sqf-ice/39_CUITBIKE/成信车队.bmp

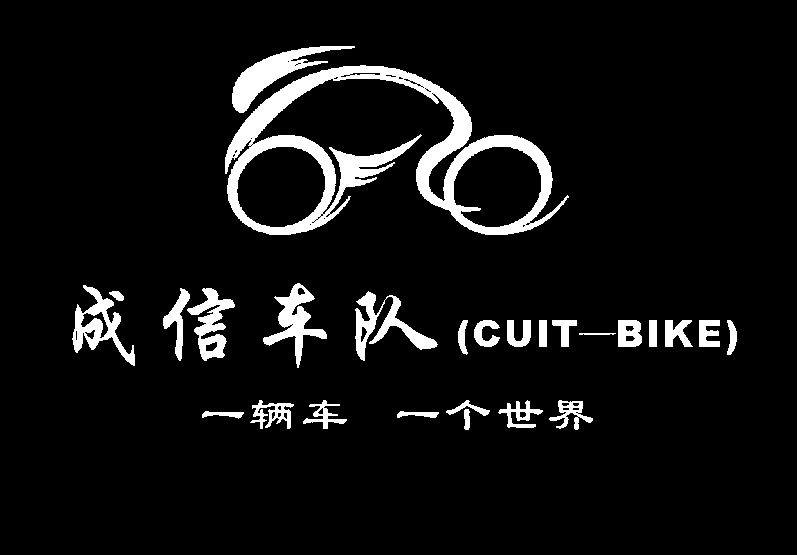
成信车队.bmp
