sqf-ice/39_CUITBIKE/v1.2/SCH/cuitbike_v1_2.pdf

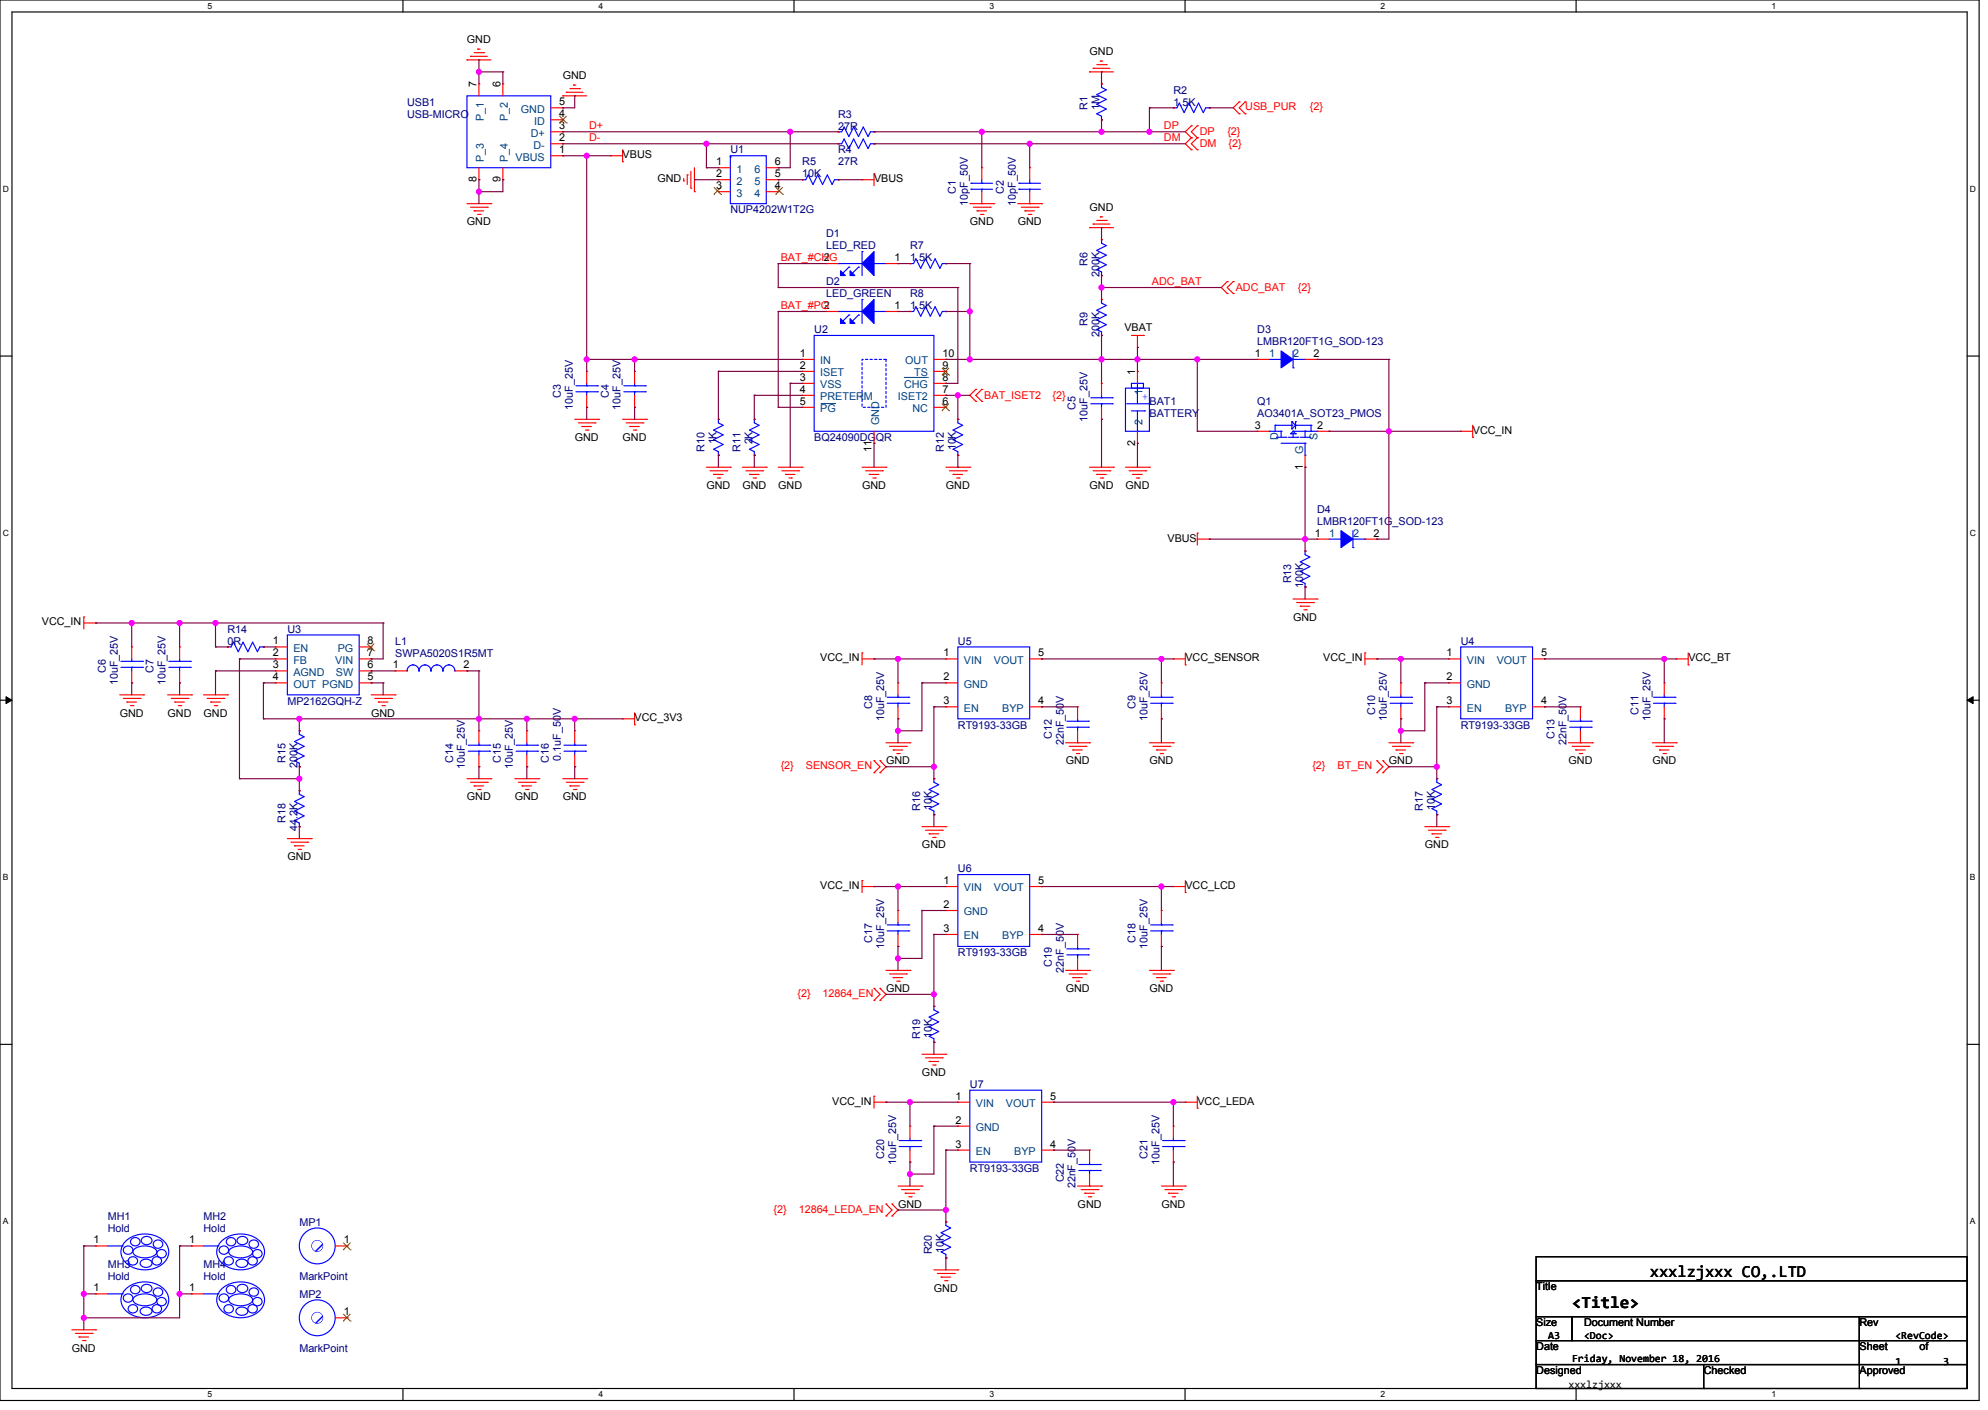
[picture p2: page 1]

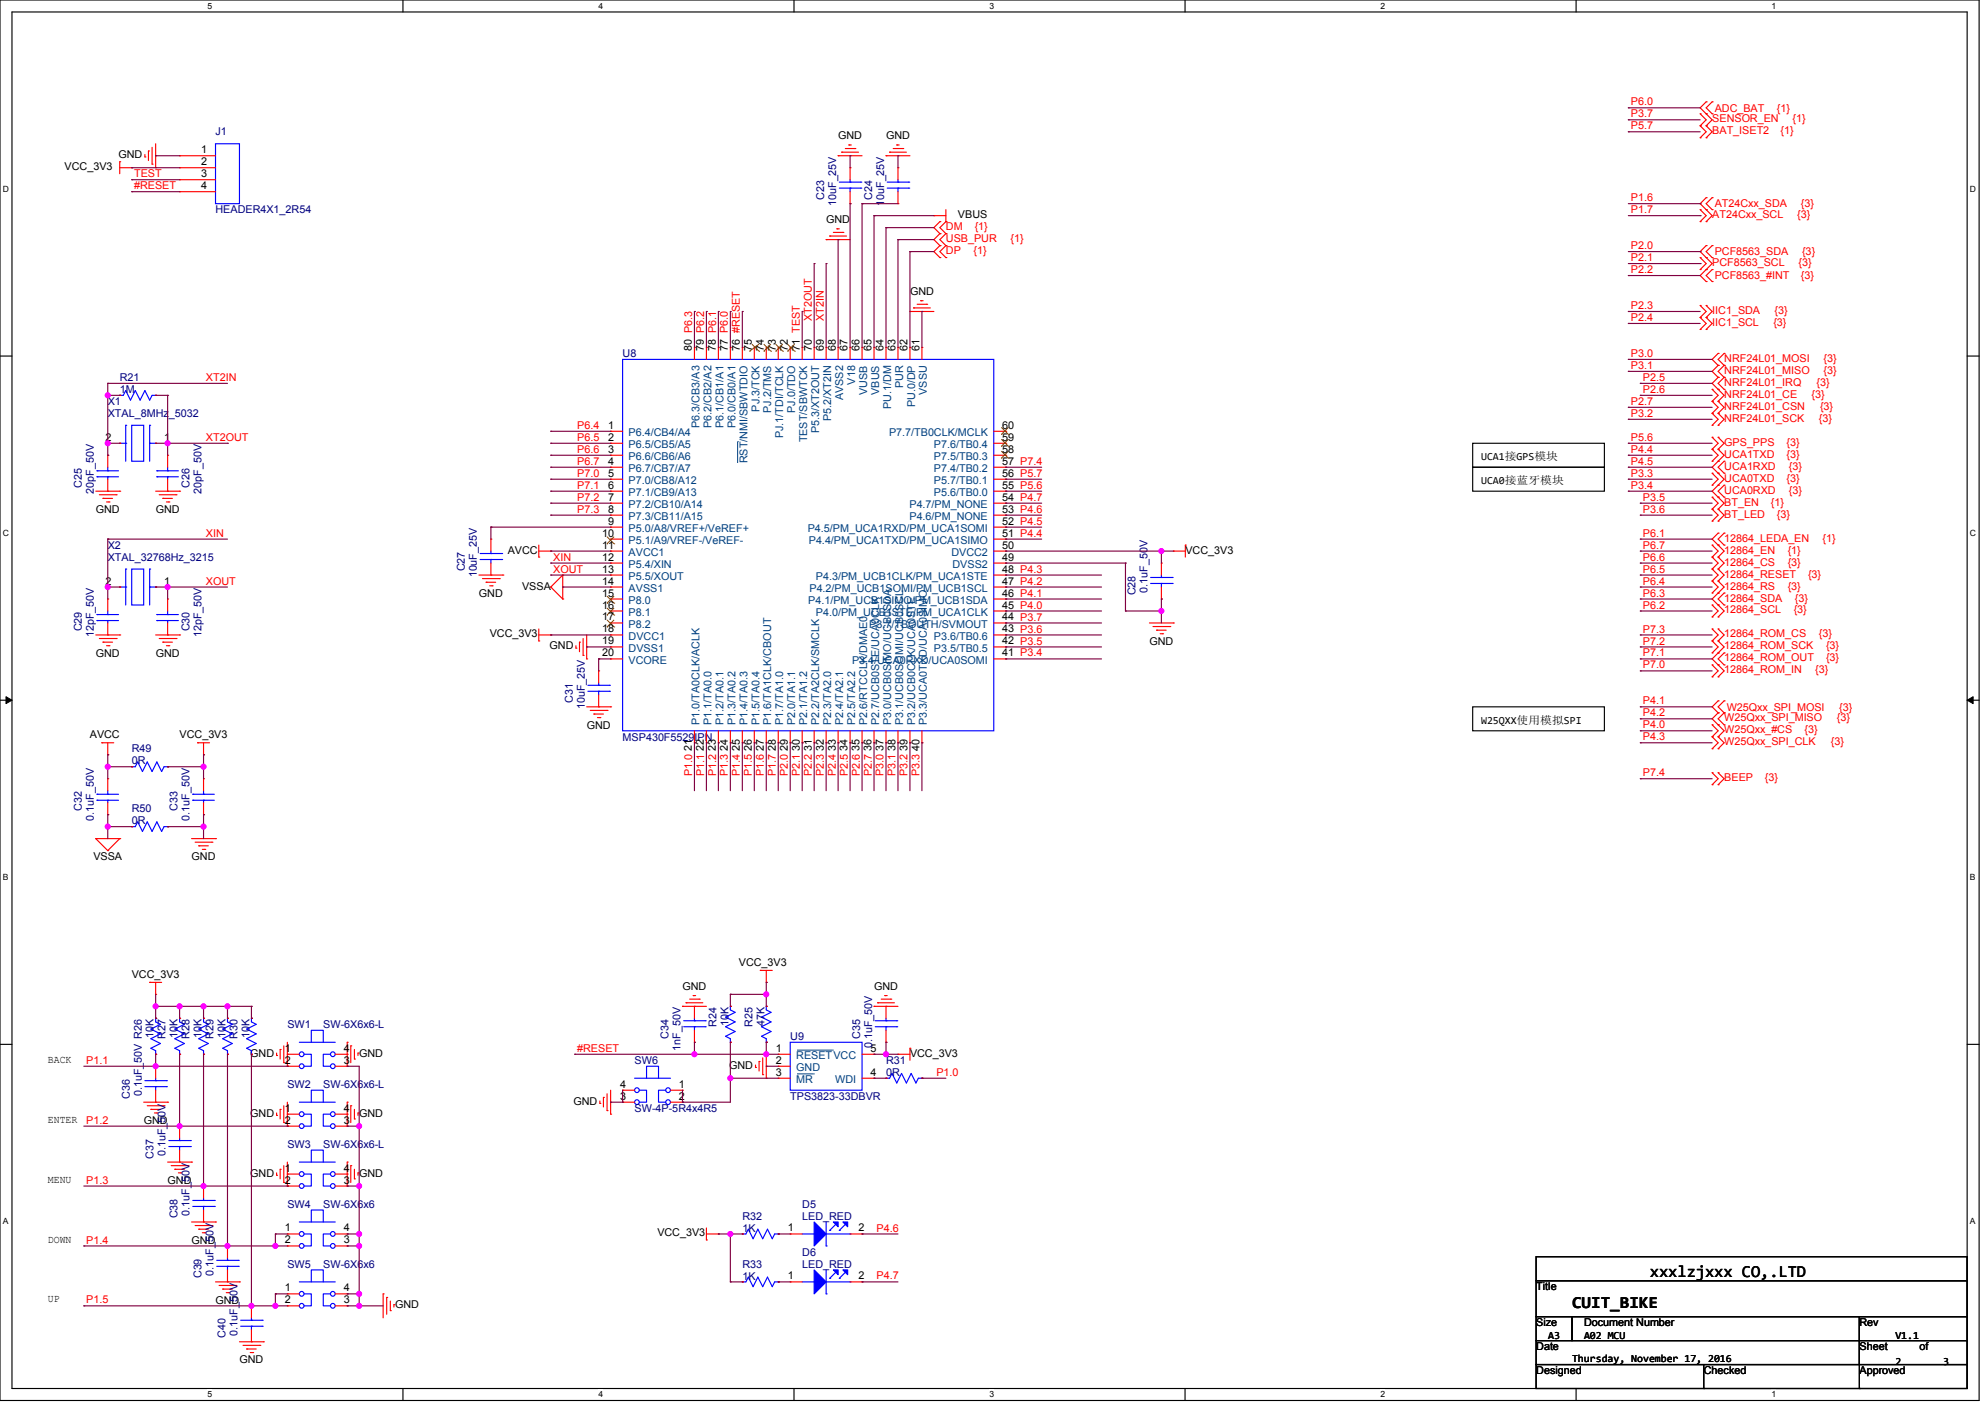
[picture p3: page 2]

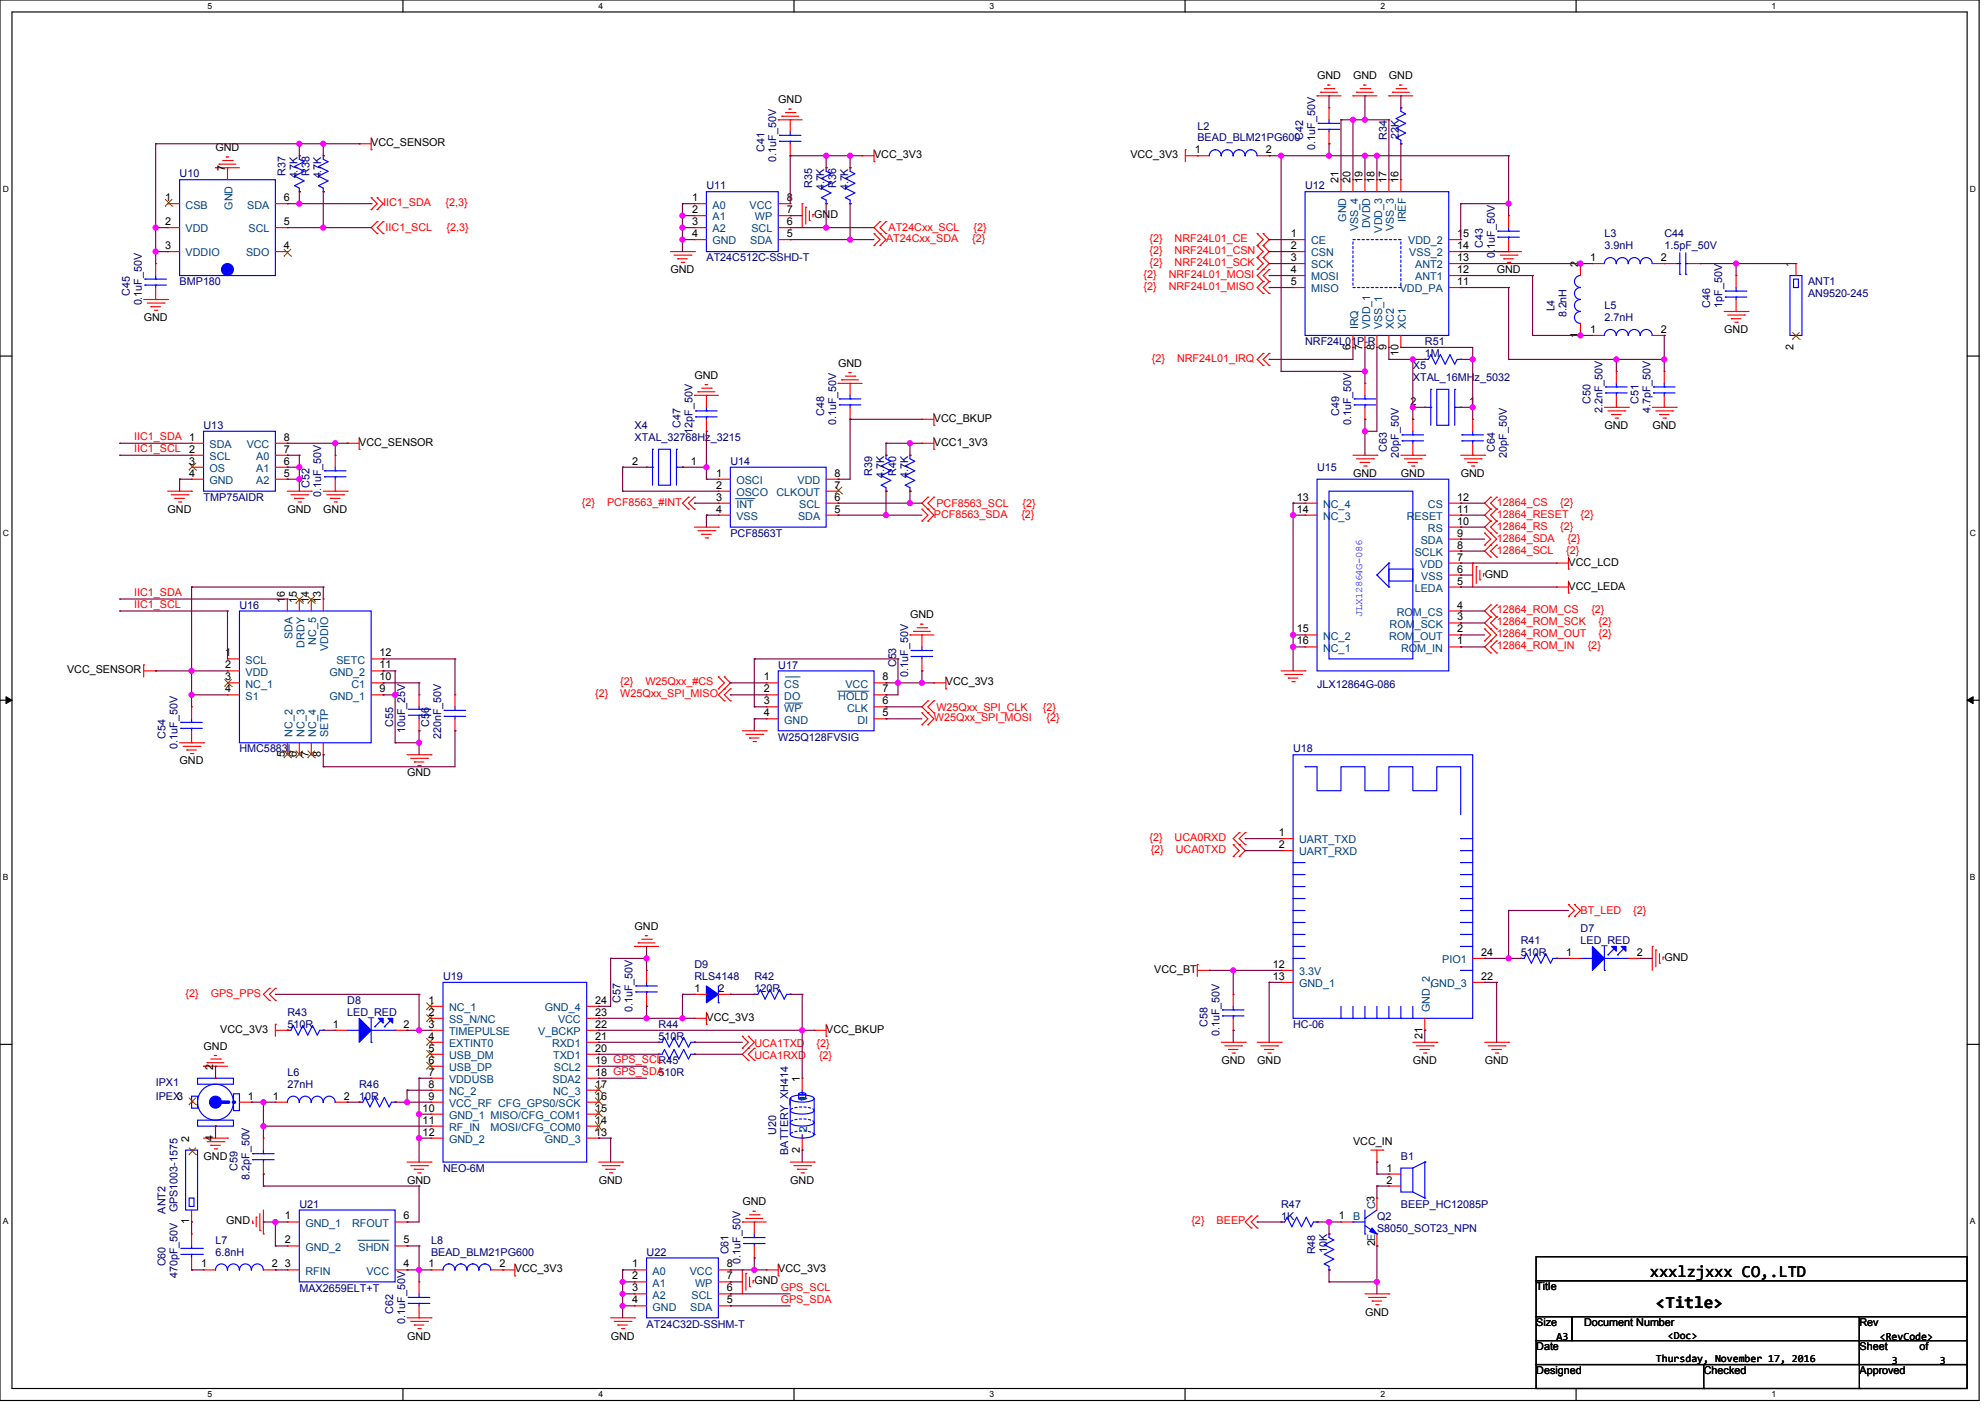
[picture p4: page 3]

SETP 8 GND_1 9 C1 10 GND_2 11 SETC 12 VDDIO 13 NC_5 14 DRDY 15 SDA 16
