sqf-ice/39_CUITBIKE/v1.1/cuitbike_v1_1_stm32.pdf

D | D

## MODE：模式选择。1：burst模式，高效率高纹波。0：pwm模式。

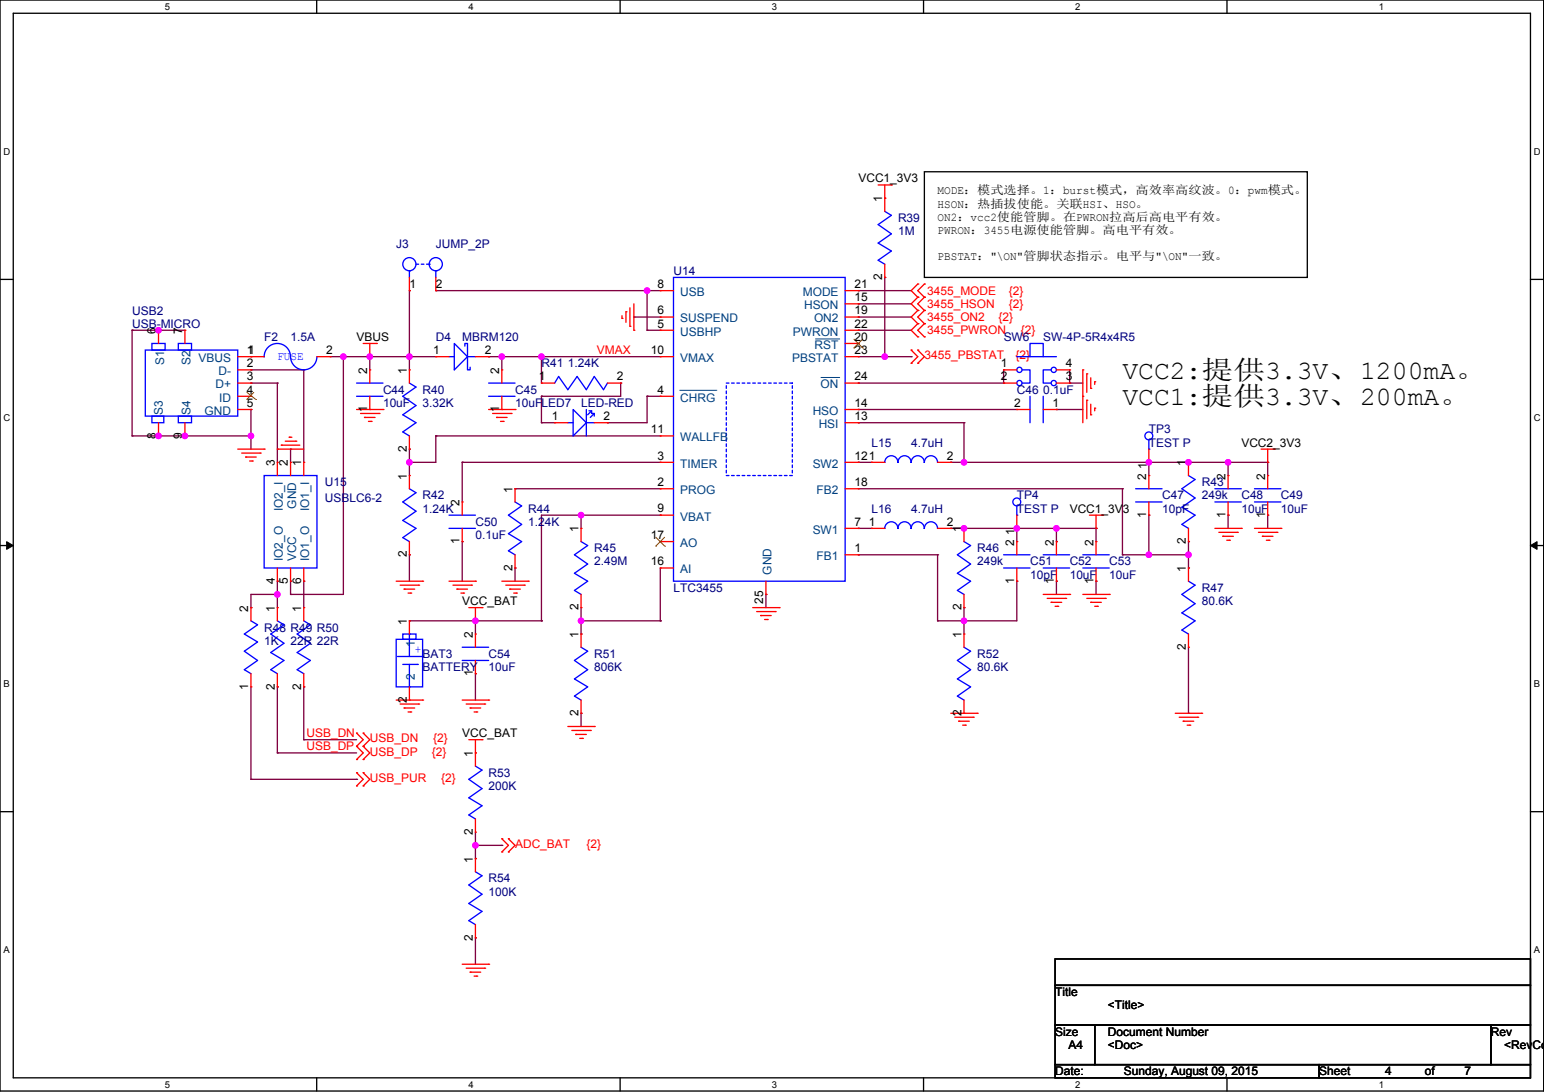
[picture p15: page 1]

HSON：热插拔使能。关联HSI、HSO。
ON2：vcc2使能管脚。在PWRON拉高后高电平有效。
PWRON：3455电源使能管脚。高电平有效。

PBSTAT："\ON"管脚状态指示。电平与"\ON"一致。

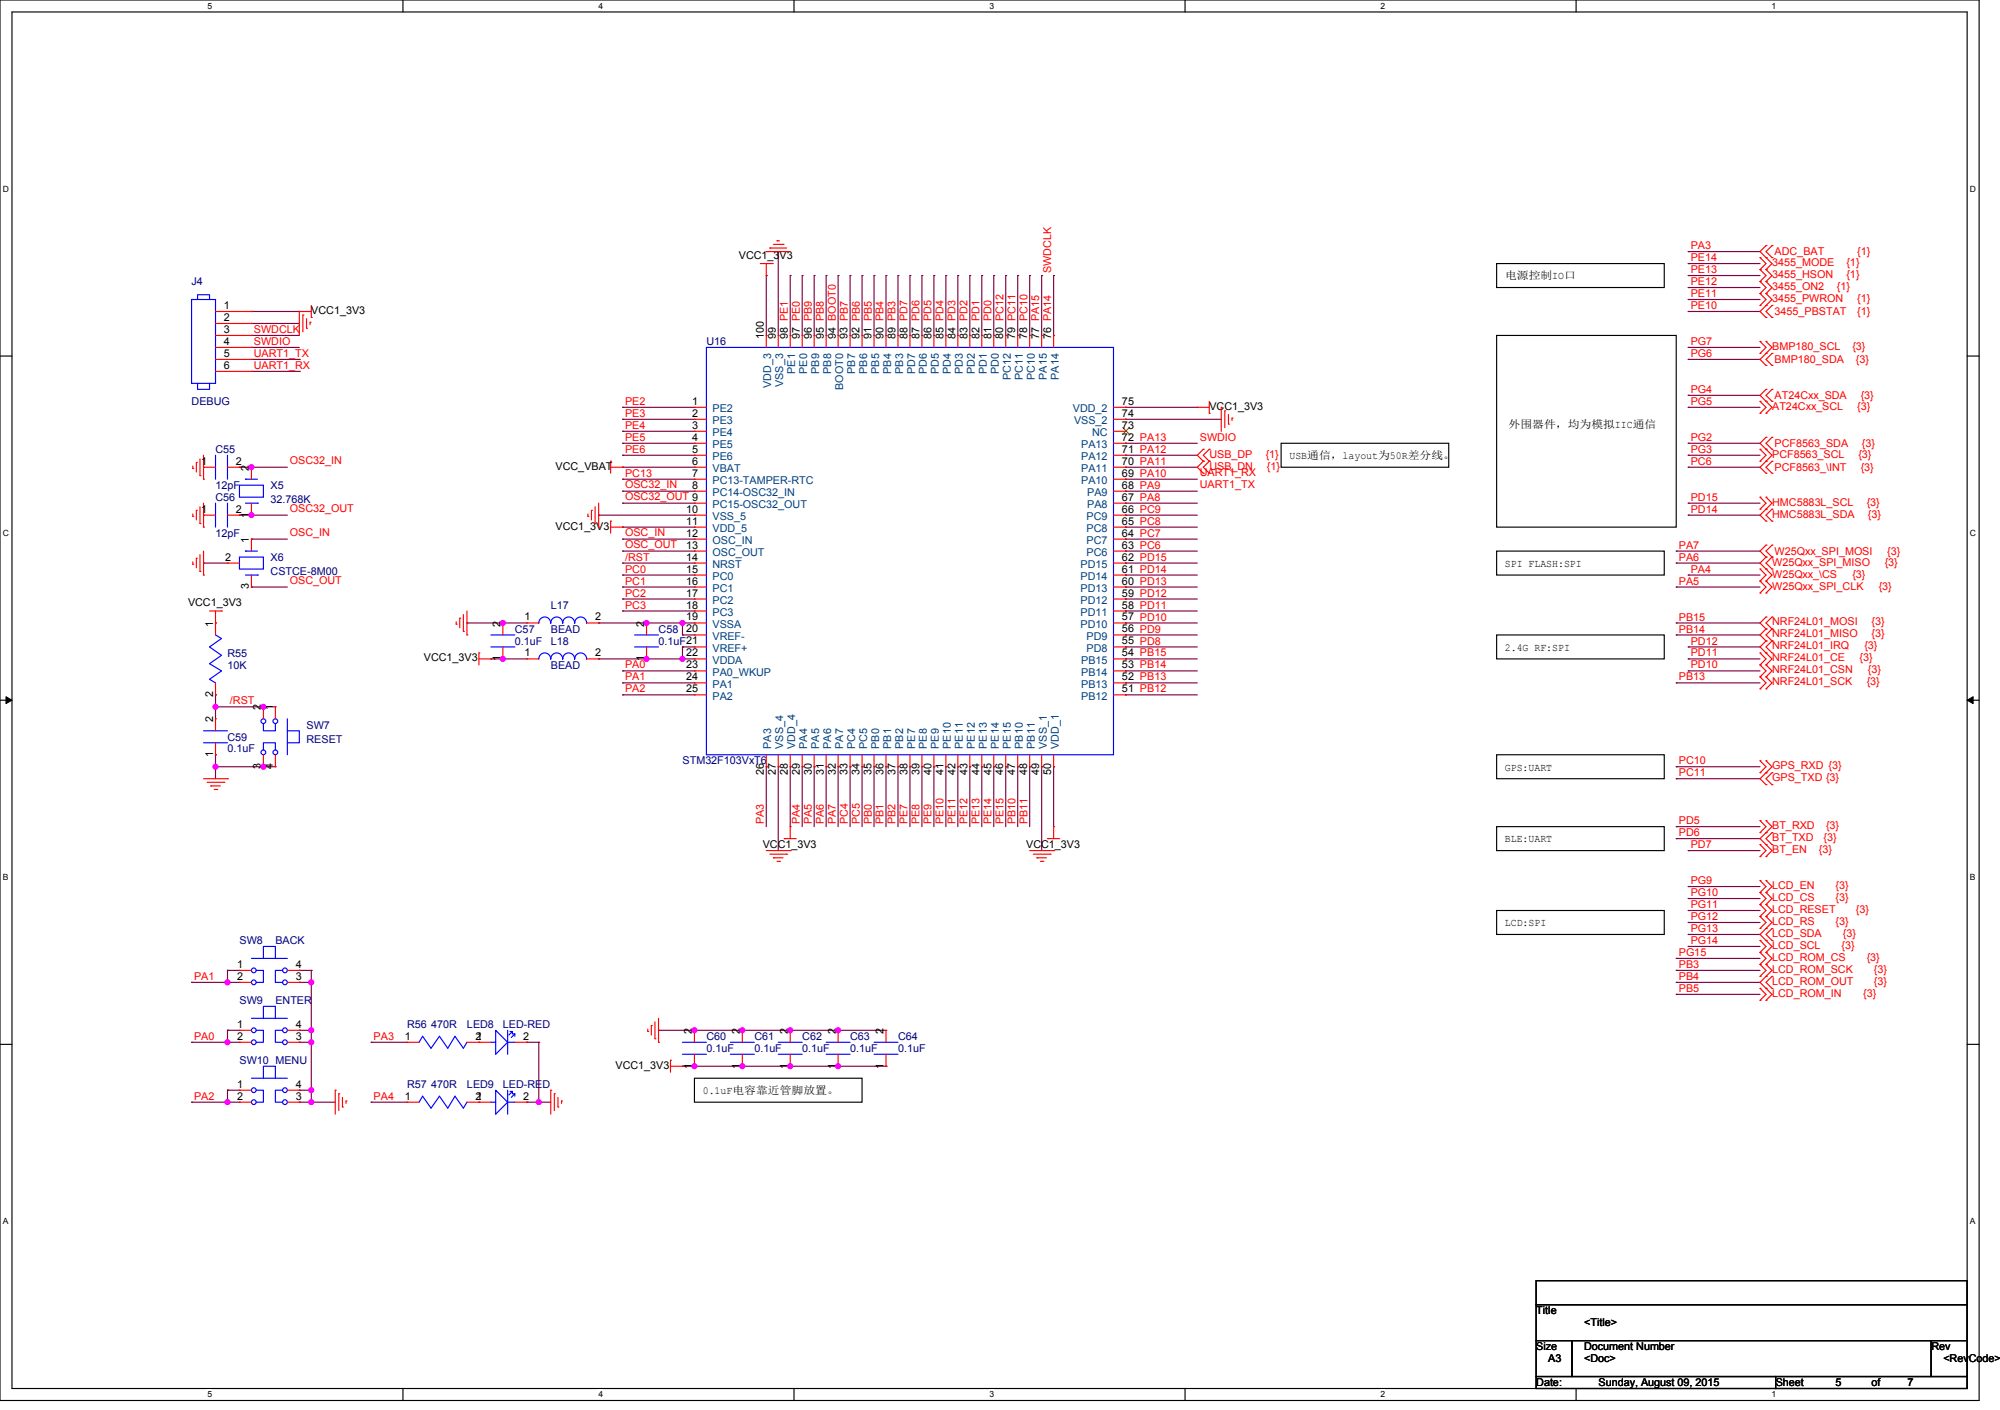
[picture p16: page 2]

气压传感器 | EEPROM | RTC

2.4G

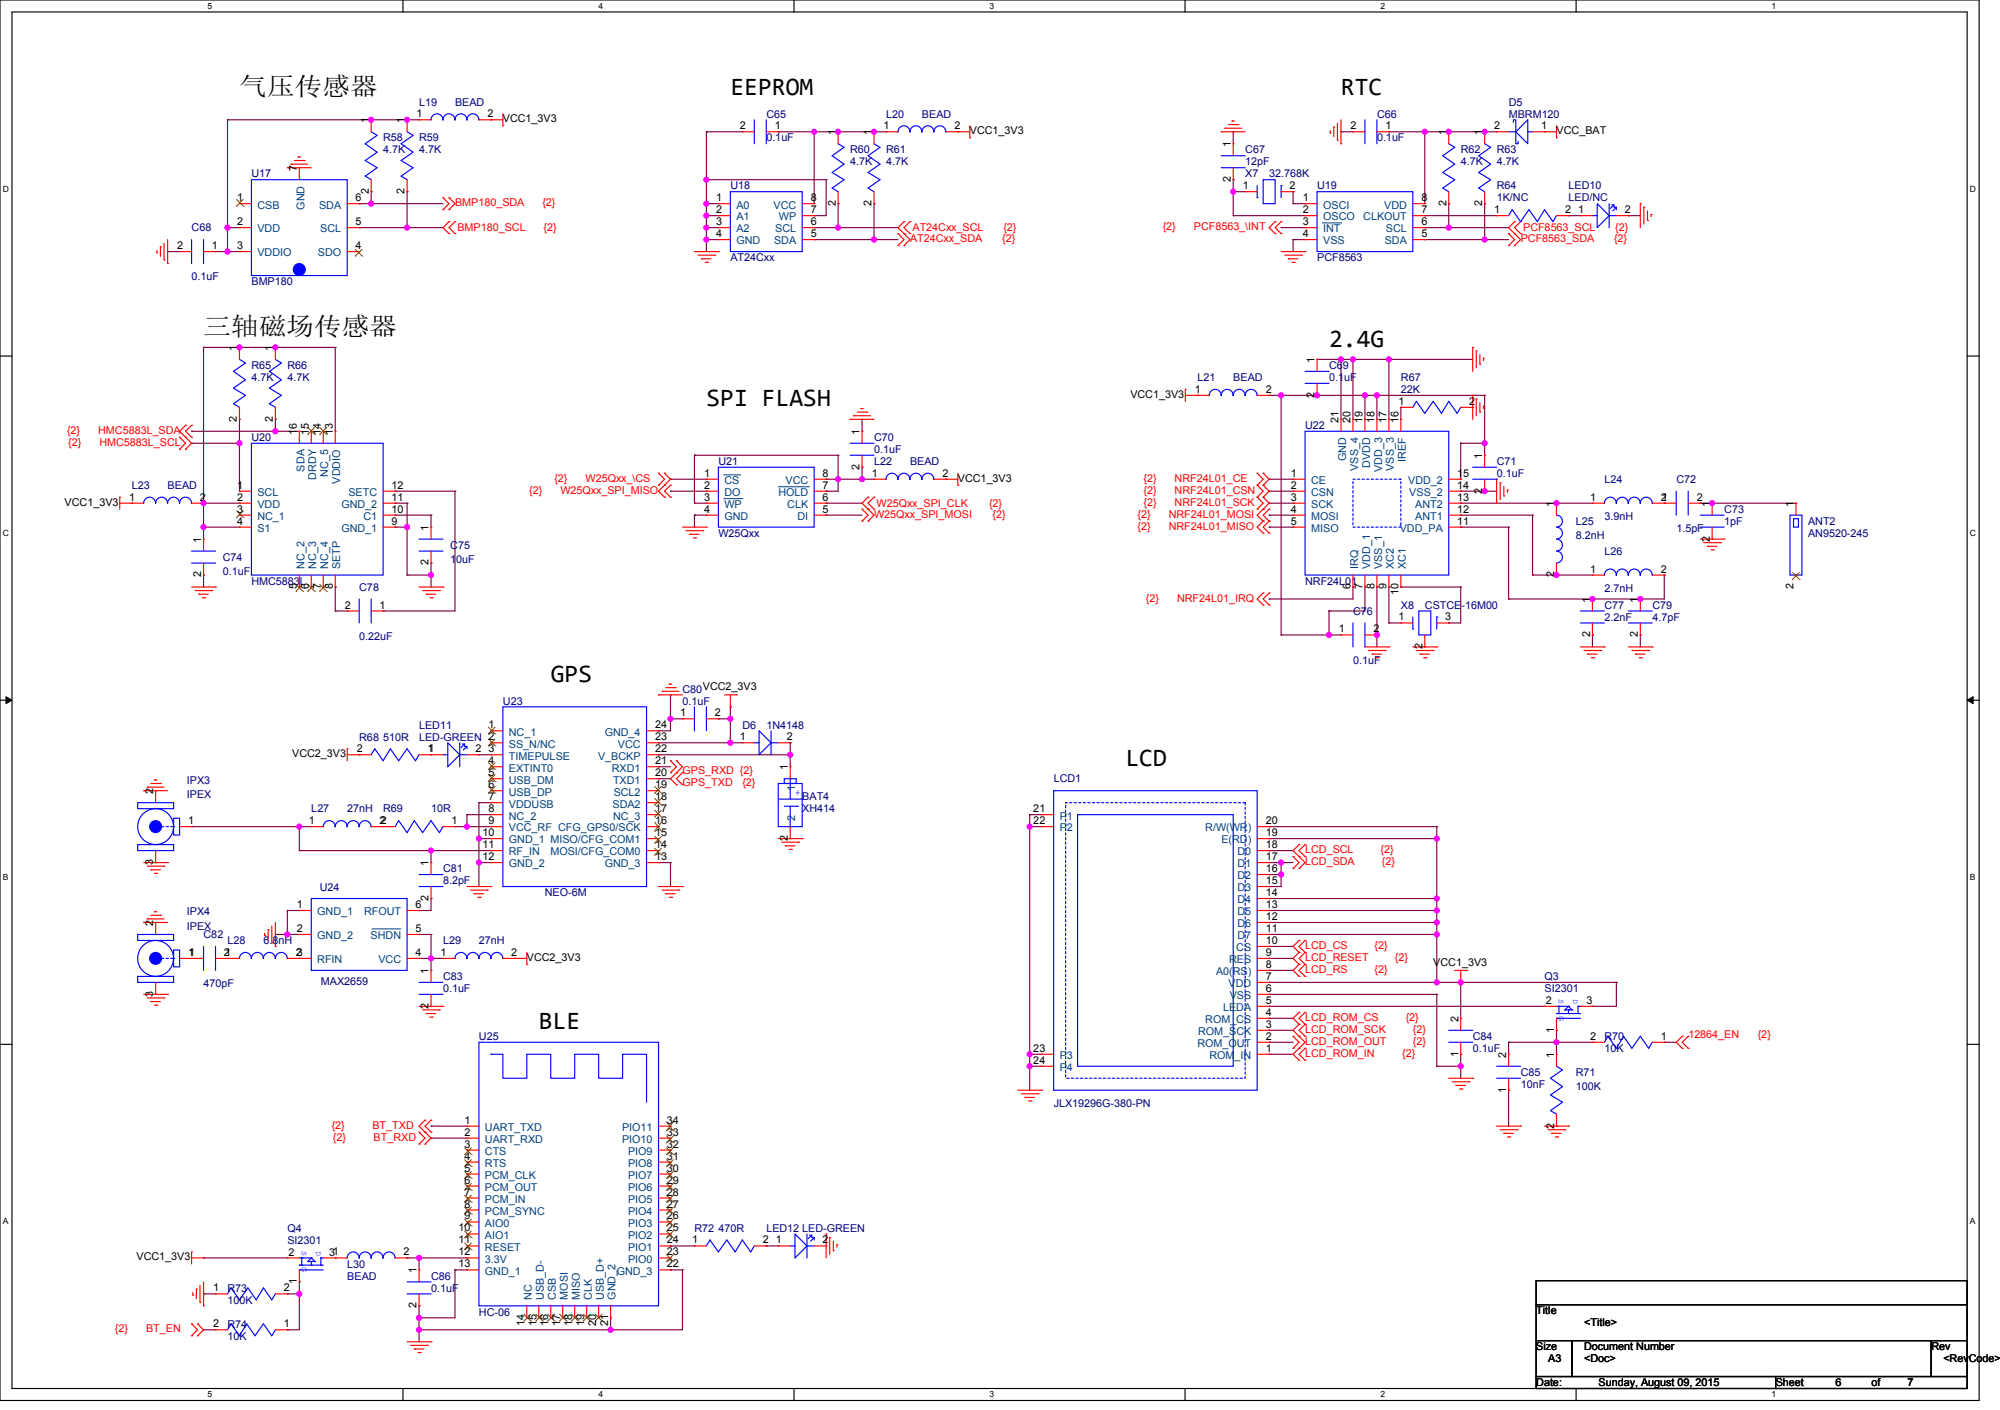
[picture p17: page 3]

SETP 8 GND_1 9 C1 10 GND_2 11 SETC 12 VDDIO 13 NC_5 14 DRDY 15 SDA 16
