sqf-ice/39_CUITBIKE/v1.1/cuitbike_v1_1_RF.pdf

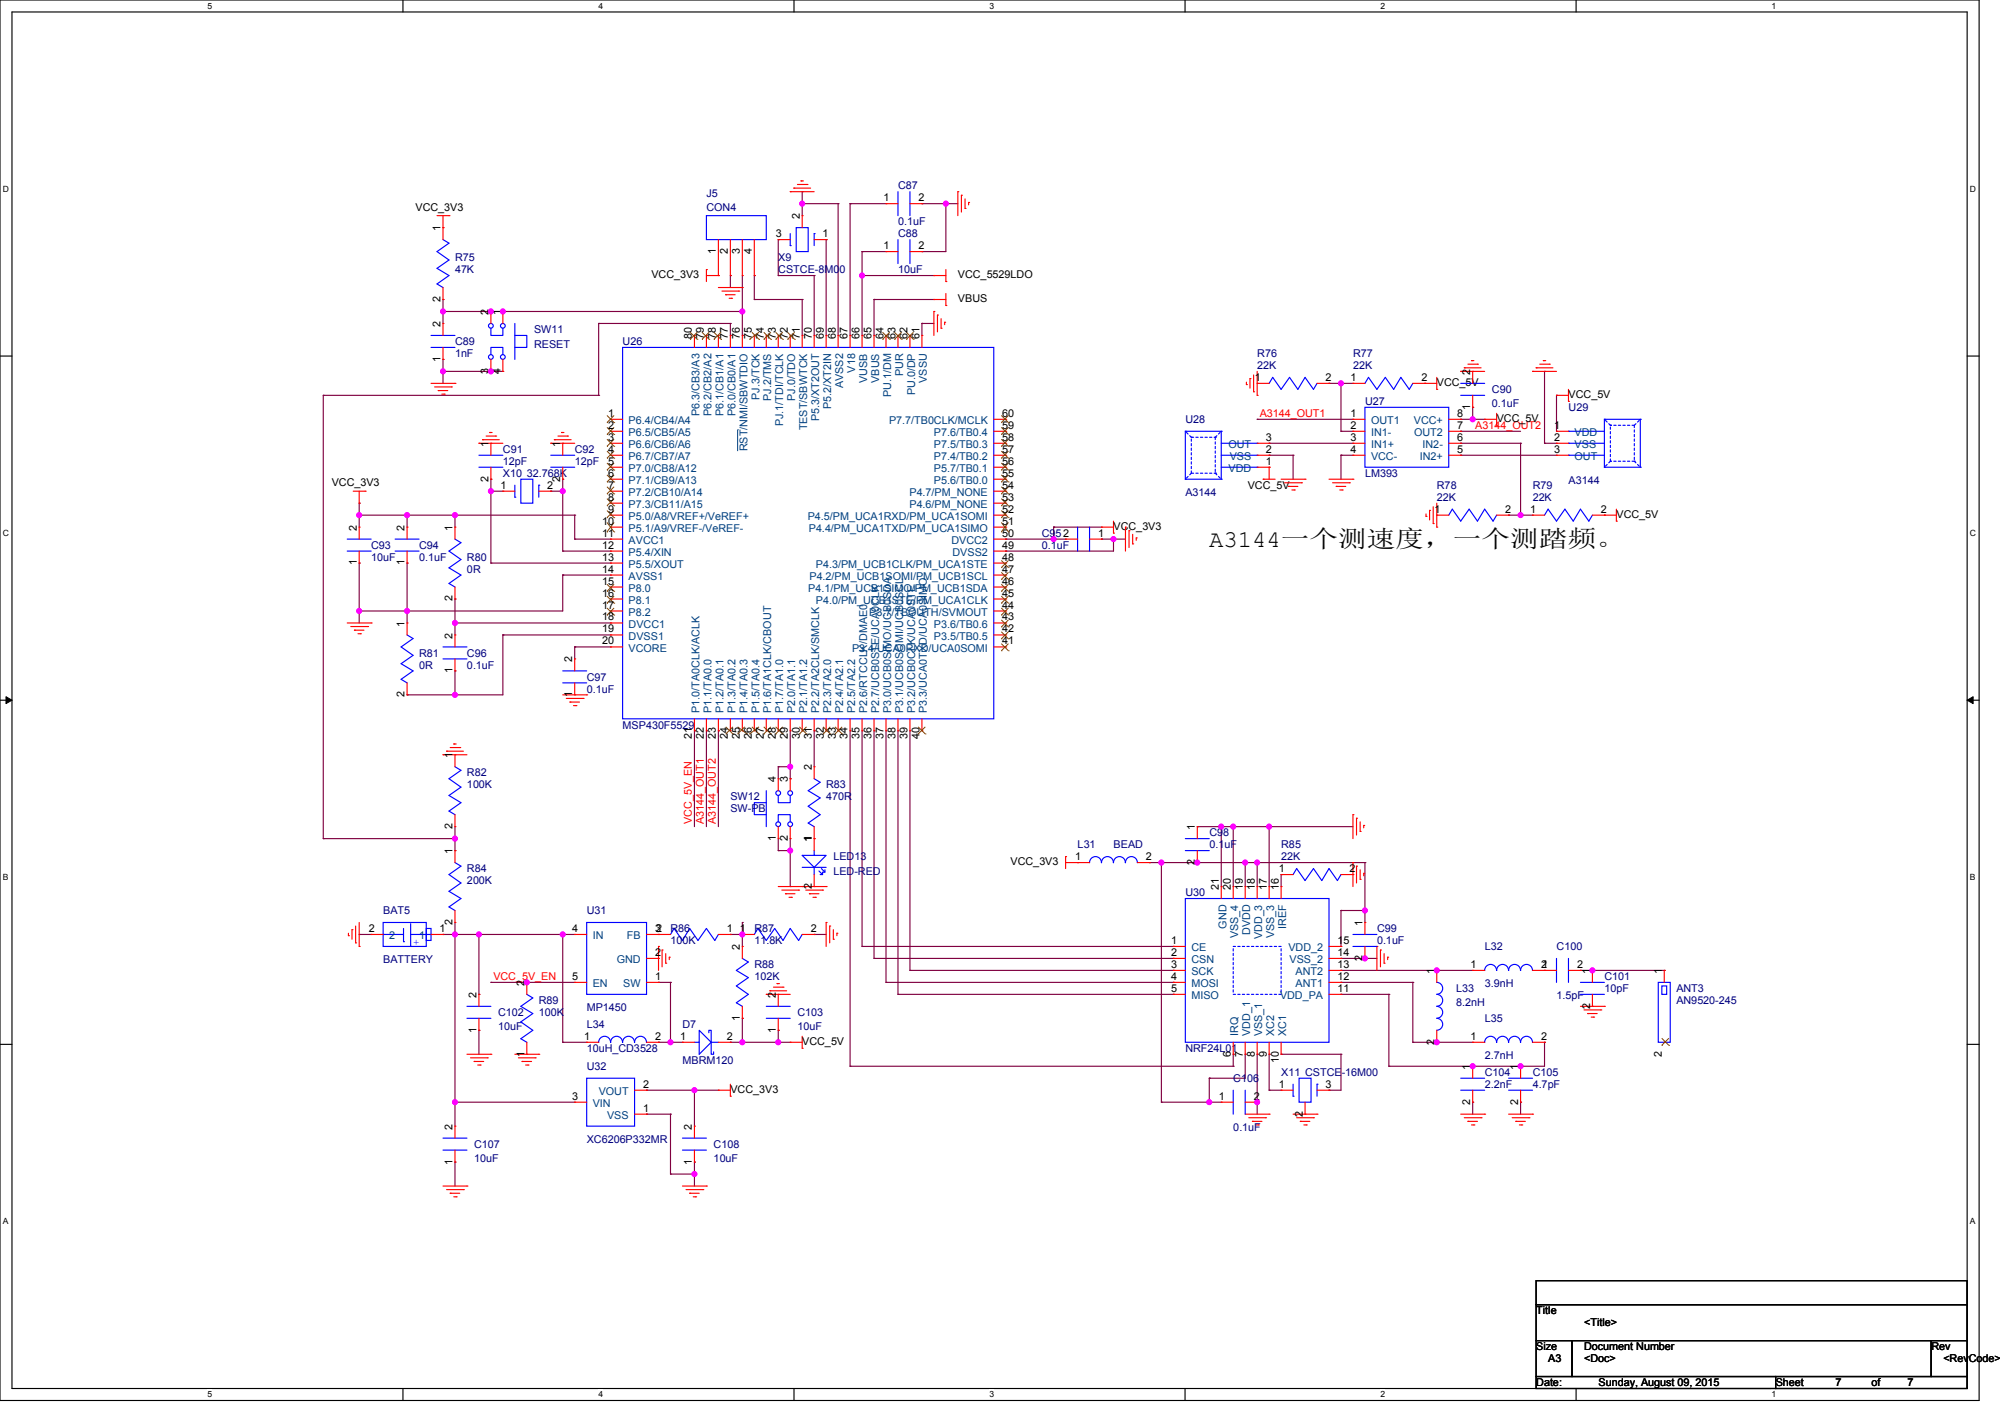
[picture p18: page 1]
