sqf-ice/39_CUITBIKE/(list of files, drawings)

Other design files:
v1.0/Imported MSP430FR5969v1.0.PrjPcb/FR5969v1.0.PcbLib
v1.0/Imported MSP430FR5969v1.0.PrjPcb/FR5969v1.0.PrjPcb
v1.0/Imported MSP430FR5969v1.0.PrjPcb/FR5969v1.0.SchDoc
v1.0/Imported MSP430FR5969v1.0.PrjPcb/FR5969v1.0.SchLib
v1.0/Imported MSP430FR5969v1.0.PrjPcb/LCD.SchDoc
v1.0/Imported MSP430FR5969v1.0.PrjPcb/Modular.SchDoc
v1.0/Imported MSP430FR5969v1.0.PrjPcb/MSP430FRxxxx.SchDoc
v1.0/Imported MSP430FR5969v1.0.PrjPcb/POWER.SchDoc
v1.1/SCH/CUITBIKE_V1_1.DSN
v1.1/SCH/CUITBIKE_V1_1.opj
v1.2/SCH/CUITBIKE_V1_2.DSN
v1.2/SCH/CUITBIKE_V1_2.opj
