sqf-ice/39_CUITBIKE/CUITBIKE_V12_MSP430-SV10_161201_D/HARDWARE/JLX12864/LCD12864.c

/*
 * LCD12864.c
 *
 *  Created on: 2014-11-29
 *      Author: dell
 */


#include "includes.h"

//***********************************************************************
const unsigned char page1[] = {
/*--  调入了一幅图像：C:\Users\xxxlzjxxx\Desktop\页面1 - 副本.bmp  --*/
/*--  宽度x高度=128x64  --*/
0x00,0x00,0x00,0x00,0x00,0x00,0x00,0x00,0x00,0x80,0x80,0x80,0x80,0x00,0x00,0x00,
0x00,0x00,0x80,0x00,0x00,0x00,0x00,0x00,0x00,0x00,0x00,0x00,0x80,0x80,0x80,0x00,
0x00,0x00,0x00,0x00,0x00,0x00,0x00,0x00,0x00,0x00,0x00,0x00,0x00,0x80,0x80,0x80,
0x00,0x00,0x00,0x00,0x00,0x00,0x00,0x00,0x00,0x00,0x00,0x80,0x80,0x00,0x00,0x00,
0x80,0x80,0x80,0x80,0x80,0x80,0x80,0x80,0x00,0x00,0x00,0x00,0x00,0x00,0x00,0x00,
0x00,0x00,0x00,0x00,0x00,0x00,0x00,0x00,0x00,0x00,0x00,0x00,0x00,0x00,0x00,0x00,
0x00,0x00,0x00,0x00,0x00,0x00,0x00,0x00,0x00,0x00,0x00,0x00,0x00,0x00,0x00,0x00,
0x00,0x00,0x00,0x00,0x00,0x00,0x00,0x00,0x00,0x00,0x00,0x00,0x00,0x00,0x00,0x00,
0x00,0x00,0x00,0x00,0x24,0x25,0xE5,0x05,0xFF,0xFF,0x04,0xE4,0x24,0xA4,0x00,0xFE,
0x00,0x00,0xFF,0x00,0x00,0x00,0x98,0x9C,0x9C,0x9E,0x96,0x93,0x91,0xF1,0xF1,0x93,
0x97,0x9E,0x8C,0x8C,0x98,0x00,0x00,0x10,0x18,0x9C,0x8C,0x9E,0x97,0xB3,0xF1,0xF1,
0x93,0x97,0x9E,0x8C,0x9C,0x18,0x08,0x00,0x00,0x33,0x9D,0xED,0xC9,0xF9,0xB9,0x83,
0x01,0xF9,0x09,0x0F,0xEF,0x09,0xF9,0xF9,0x00,0x00,0x00,0x00,0x00,0x00,0x00,0x00,
0x00,0x30,0x30,0x00,0x00,0x00,0x00,0x00,0x00,0x00,0x00,0x00,0x00,0x03,0x61,0x61,
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

void delayms(int n_ms)
{
	int j,k;
	for(j=0;j<n_ms;j++)
	for(k=0;k<110;k++);
}
//短延时
void delayus(int n_us)
{
	int j,k;
	for(j=0;j<n_us;j++)
	for(k=0;k<1;k++);
}


//写指令到LCD 模块
void transfer_command_lcd(int data1)
{
	char i;

	CS_0();
	RS_0();

	for(i=0;i<8;i++)
	{
		SCLK_0();

		//delay_us(10); //加少量延时
		if(data1&0x80) DIN_1();
		else DIN_0();
		SCLK_1();
		//delay_us(10); //加少量延时
		data1=data1<<=1;
	}
	CS_1();
}
//写数据到LCD 模块
void transfer_data_lcd(int data1)
{
	char i;
	CS_0();
	RS_1();
	for(i=0;i<8;i++)
	{
		SCLK_0();
		if(data1&0x80) DIN_1();
		else DIN_0();
		SCLK_1();
		data1 = (data1<<=1);
	}
	CS_1();
}
//LCD 模块初始化
void Initial_lcd(void)
{
	P6DIR |=RST_PIN | SPI_MOSI_PIN| SPI_CLK_PIN|RS_PIN|CS_PIN;
	P7DIR |=Rom_IN |Rom_SCK|Rom_CS ;
	P7DIR&=~Rom_OUT;
	RST_0(); //低电平复位
	delayms(100);
	RST_1(); //复位完毕
	delayms(100);
	transfer_command_lcd(0xe2); //软复位
	delayms(5);
	transfer_command_lcd(0x2c); //升压步聚1
	delayms(50);
	transfer_command_lcd(0x2e); //升压步聚2
	delayms(50);
	transfer_command_lcd(0x2f); //升压步聚3
	delayms(5);
	transfer_command_lcd(0x23); //粗调对比度，可设置范围0x20～0x27
	transfer_command_lcd(0x81); //微调对比度
	transfer_command_lcd(0x28); //微调对比度的值，可设置范围0x00～0x3f
	transfer_command_lcd(0xa2); //1/9 偏压比（bias）
	transfer_command_lcd(0xc8); //行扫描顺序：从上到下
	transfer_command_lcd(0xa0); //列扫描顺序：从左到右
	transfer_command_lcd(0x40); //起始行：第一行开始
	transfer_command_lcd(0xaf); //开显示
}
void lcd_address(uint page,uint column)
{
	column=column-0x01;
	transfer_command_lcd(0xb0+page-1); //设置页地址，每8 行为一页，全屏共64 行，被分成8 页
	transfer_command_lcd(0x10+(column>>4&0x0f)); //设置列地址的高4 位
	transfer_command_lcd(column&0x0f); //设置列地址的低4 位
}
//全屏清屏
void clear_screen()
{
	unsigned char i,j;
	for(i=0;i<9;i++)
	{
		transfer_command_lcd(0xb0+i);
		transfer_command_lcd(0x10);
		transfer_command_lcd(0x00);
		for(j=0;j<132;j++)
		{
			transfer_data_lcd(0x00);
		}
	}
}
//显示128x64 点阵图像
void display_128x64(const uchar *dp)
{
	uint i,j;
	for(j=0;j<8;j++)
	{
		lcd_address(j+1,1);
		for (i=0;i<128;i++)
		{
			transfer_data_lcd(*dp); //写数据到LCD,每写完一个8 位的数据后列地址自动加1
			dp++;
		}
	}
}
//显示16x16 点阵图像、汉字、生僻字或16x16 点阵的其他图标
void display_graphic_16x16(uchar page,uchar column,const uchar *dp)
{
	uint i,j;
	for(j=0;j<2;j++)
	{
		lcd_address(page+j,column);
		for (i=0;i<16;i++)
		{
			transfer_data_lcd(*dp); //写数据到LCD,每写完一个8 位的数据后列地址自动加1
			dp++;
		}
	}
}
//显示8x16 点阵图像、ASCII, 或8x16 点阵的自造字符、其他图标
void display_graphic_8x16(uchar page,uchar column,const uchar *dp)
{
	uint i,j;
	for(j=0;j<2;j++)
	{
		lcd_address(page+j,column);
		for (i=0;i<8;i++)
		{
			transfer_data_lcd(*dp); //写数据到LCD,每写完一个8 位的数据后列地址自动加1
			dp++;
		}
	}
}
//显示5X8 点阵图像、ASCII, 或5x8 点阵的自造字符、其他图标
void display_graphic_5x8(uchar page,uchar column,const uchar *dp)
{
	uint i;
	lcd_address(page,column);
	for (i=0;i<6;i++)
	{
		transfer_data_lcd(*dp);
		dp++;
	}
}
//送指令到晶联讯字库IC
void send_command_to_ROM( uchar datu )
{
	uchar i;
	for(i=0;i<8;i++ )
	{
		Rom_SCK_0();
		delayus(10);
		if(datu&0x80)  Rom_IN_1();
				else Rom_IN_0();
		datu = datu<<1;
		Rom_SCK_1();
		delayus(10);
	}
}
//从晶联讯字库IC 中取汉字或字符数据（1 个字节）
static uchar get_data_from_ROM( )
{
	uchar i;
	uchar ret_data=0;
	for(i=0;i<8;i++)
	{
		Rom_OUT_1();
		Rom_SCK_0();
		//delay_us(1);
		ret_data=ret_data<<1;
		if( Rom_OUT_BIT )
		ret_data=ret_data+1;
		else
		ret_data=ret_data+0;
		Rom_SCK_1();
		//delay_us(1);
	}
	return(ret_data);
}
//从指定地址读出数据写到液晶屏指定（page,column)座标中
void get_and_write_16x16(ulong fontaddr,uchar page,uchar column)
{
	uchar i,j,disp_data;
	Rom_CS_0();
	send_command_to_ROM(0x03);
	send_command_to_ROM((fontaddr&0xff0000)>>16); //地址的高8 位,共24 位
	send_command_to_ROM((fontaddr&0xff00)>>8); //地址的中8 位,共24 位
	send_command_to_ROM(fontaddr&0xff); //地址的低8 位,共24 位
	for(j=0;j<2;j++)
	{
		lcd_address(page+j,column);
		for(i=0; i<16; i++ )
		{
			disp_data=get_data_from_ROM();
			transfer_data_lcd(disp_data); //写数据到LCD,每写完1 字节的数据后列地址自动加1
		}
	}
	Rom_CS_1();
}
//从指定地址读出数据写到液晶屏指定（page,column)座标中
void get_and_write_8x16(ulong fontaddr,uchar page,uchar column)
{
	uchar i,j,disp_data;
	Rom_CS_0();
	send_command_to_ROM(0x03);
	send_command_to_ROM((fontaddr&0xff0000)>>16); //地址的高8 位,共24 位
	send_command_to_ROM((fontaddr&0xff00)>>8); //地址的中8 位,共24 位
	send_command_to_ROM(fontaddr&0xff); //地址的低8 位,共24 位
	for(j=0;j<2;j++)
	{
		lcd_address(page+j,column);
		for(i=0; i<8; i++ )
		{
			disp_data=get_data_from_ROM();
			transfer_data_lcd(disp_data); //写数据到LCD,每写完1 字节的数据后列地址自动加1
		}
	}
	Rom_CS_1();
}
//从指定地址读出数据写到液晶屏指定（page,column)座标中
void get_and_write_5x8(ulong fontaddr,uchar page,uchar column)
{
	uchar i,disp_data;
	Rom_CS_0();
	send_command_to_ROM(0x03);
	send_command_to_ROM((fontaddr&0xff0000)>>16); //地址的高8 位,共24 位
	send_command_to_ROM((fontaddr&0xff00)>>8); //地址的中8 位,共24 位
	send_command_to_ROM(fontaddr&0xff); //地址的低8 位,共24 位
	lcd_address(page,column);
	for(i=0; i<5; i++ )
	{
		disp_data=get_data_from_ROM();
		transfer_data_lcd(disp_data); //写数据到LCD,每写完1 字节的数据后列地址自动加1
	}
	Rom_CS_1();
}
//****************************************************************
ulong fontaddr=0;
void display_GB2312_string(uchar page,uchar column,char *text)
{
	uchar i= 0;
	while((text[i]>0x00))
	{
		if(((text[i]>=0xb0) &&(text[i]<=0xf7))&&(text[i+1]>=0xa1))
		{
			//国标简体（GB2312）汉字在晶联讯字库IC 中的地址由以下公式来计算：
			//Address = ((MSB - 0xB0) * 94 + (LSB - 0xA1)+ 846)*32+ BaseAdd;BaseAdd=0
			//由于担心8 位单片机有乘法溢出问题，所以分三部取地址
			fontaddr = (text[i]- 0xb0)*94;
			fontaddr += (text[i+1]-0xa1)+846;
			fontaddr = (ulong)(fontaddr*32);
			get_and_write_16x16(fontaddr,page,column); //从指定地址读出数据写到液晶屏指定（page,column)座标中
			i+=2;
			column+=16;
		}
		else if(((text[i]>=0xa1) &&(text[i]<=0xa3))&&(text[i+1]>=0xa1))
		{
			//国标简体（GB2312）15x16 点的字符在晶联讯字库IC 中的地址由以下公式来计算：
			//Address = ((MSB - 0xa1) * 94 + (LSB - 0xA1))*32+ BaseAdd;BaseAdd=0
			//由于担心8 位单片机有乘法溢出问题，所以分三部取地址
			fontaddr = (text[i]- 0xa1)*94;
			fontaddr += (text[i+1]-0xa1);
			fontaddr = (ulong)(fontaddr*32);
			get_and_write_16x16(fontaddr,page,column); //从指定地址读出数据写到液晶屏指定（page,column)座标中
			i+=2;
			column+=16;
		}
		else if((text[i]>=0x20) &&(text[i]<=0x7e))
		{
			fontaddr = (text[i]- 0x20);
			fontaddr = (unsigned long)(fontaddr*16);
			fontaddr = (unsigned long)(fontaddr+0x3cf80);
			get_and_write_8x16(fontaddr,page,column); //从指定地址读出数据写到液晶屏指定（page,column)座标中
			i+=1;
			column+=8;
		}
		else
			i++;
	}
}
void display_string_5x8(uchar page,uchar column,char *text)
{
	unsigned char i= 0;
	while((text[i]>0x00))
	{
		if((text[i]>=0x20) &&(text[i]<=0x7e))
		{
			fontaddr = (text[i]- 0x20);
			fontaddr = (unsigned long)(fontaddr*8);
			fontaddr = (unsigned long)(fontaddr+0x3bfc0);
			get_and_write_5x8(fontaddr,page,column); //从指定地址读出数据写到液晶屏指定（page,column)座标中
			i+=1;
			column+=6;
		}
		else
		i++;
	}
}
