sqf-ice/39_CUITBIKE/CUITBIKE_V12_MSP430-SV10_161201_D/HARDWARE/JLX12864/PIX.h

/*
 * PIX.h
 *
 *  Created on: 2014-11-29
 *      Author: dell
 */

#ifndef __PIX_H
#define __PIX_H

//#define uchar unsigned char
//#define uint unsigned int
//#define ulong unsigned long
//
//
//const uchar  jiong1[]={//-- 文字: 囧 --
////-- 宋体12; 此字体下对应的点阵为：宽x 高=16x16 --
//0x00,0xFE,0x82,0x42,0xA2,0x9E,0x8A,0x82,0x86,0x8A,0xB2,0x62,0x02,0xFE,0x00,0x00,
//0x00,0x7F,0x40,0x40,0x7F,0x40,0x40,0x40,0x40,0x40,0x7F,0x40,0x40,0x7F,0x00,0x00};
//const uchar  lei1[]={//-- 文字: 畾 --
////-- 宋体12; 此字体下对应的点阵为：宽x 高=16x16 --
//0x80,0x80,0x80,0xBF,0xA5,0xA5,0xA5,0x3F,0xA5,0xA5,0xA5,0xBF,0x80,0x80,0x80,0x00,
//0x7F,0x24,0x24,0x3F,0x24,0x24,0x7F,0x00,0x7F,0x24,0x24,0x3F,0x24,0x24,0x7F,0x00};
////延时

//const uchar  bmp1[]={
////-- 调入了一幅图像：D:\我的文档\My Pictures\12864-555.bmp --
////-- 宽度x 高度=128x64 --
//0x00,0x00,0x00,0x00,0x00,0x00,0x00,0x00,0x00,0x00,0x00,0x00,0x00,0x00,0x00,0x00,
//0x00,0x00,0x00,0x80,0x80,0xC0,0xC0,0xC0,0xC0,0xE0,0x60,0xE0,0xE0,0xE0,0xE0,0x60,
//0x60,0x60,0x60,0x60,0x60,0x60,0xE0,0xE0,0xE0,0xE0,0xC0,0xC0,0xC0,0xC0,0x80,0x80,
//0x00,0x00,0x00,0x00,0x00,0x00,0x00,0x00,0x00,0x00,0x00,0x00,0x00,0x00,0x00,0x00,
//0x00,0x00,0x00,0x00,0x00,0x00,0x00,0x00,0x00,0x00,0x00,0x00,0x00,0x00,0x00,0x00,
//0x00,0x00,0x00,0x00,0x00,0x00,0x00,0x00,0x00,0x00,0x00,0x00,0x00,0x00,0x00,0x00,
//0x00,0x00,0x00,0x00,0x00,0x00,0x00,0x00,0x00,0x00,0x00,0x00,0x00,0x00,0x00,0x00,
//0x00,0x00,0x00,0x00,0x00,0x00,0x00,0x00,0x00,0x00,0x00,0x00,0x00,0x00,0x00,0x00,
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
//0x80,0xC0,0xE0,0xF0,0x78,0x3C,0x1E,0x0F,0x07,0x03,0x01,0x00,0x01,0x01,0x03,0x07,
//0x0F,0x1E,0x1E,0x0E,0x0F,0x07,0x03,0x01,0x01,0x00,0x01,0x01,0x03,0x07,0x0F,0x1E,
//0x3C,0x78,0xF0,0xE0,0xC0,0x80,0x00,0x00,0x00,0xFF,0xFF,0xFF,0x00,0x00,0x00,0x00,
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
//};
#endif /* __PIX_H */
