sqf-ice/39_CUITBIKE/CUITBIKE_V12_MSP430-SV10_161201_D/SYSTEM/USART/uart.h

/** 修改日志：
******************************************************************************/
#ifndef __UART_H
#define __UART_H

/*****************************************************************************
** 管脚定义
*****************************************************************************/
#define USART_TX_232_SEL P5SEL|=BIT6 //232发送端口
#define USART_RX_232_SEL P5SEL|=BIT7 //232接收端口                 
/*******************************************************************************
** 函数声明
*******************************************************************************/
void Send_232_data(uchar *tdata,uint data_length);
void Usart_Wire_Temp_Init_9600(void);
void Usart_GPIO_Init(void) ;
void Send_Wave_Check(void);

void Receive_232_data(void);
void RecevieBufReading(unsigned char *RxBuf);
void ReplyTrue(void);
void ReplyFalse(void);
void ReplyAmplitudeAndFrequency(void);
void ReplyWaveform(void);
void ReplyVoltageAndTemperature(void);


#endif
