sqf-ice/39_CUITBIKE/CUITBIKE_V12_MSP430-SV10_161201_D/USER/includes.h

#ifndef __INCLUDES_H
#define __INCLUDES_H

#define uchar unsigned char  
#define uint unsigned int
#define ushort unsigned short 

//******************************************************************************

#define HighBytePosition 1	//定义串口高低字节顺序。若为1，高字节在前；若为0，高字节在后。

//******************************************************************************

#include        "msp430f5529.h"

#include 		"math.h"
#include 		"stdio.h"
#include        "string.h"

#include        "wdog.h"
#include        "GPIO.h"
#include        "sysclk.h"
#include        "fft.h"
#include        "timer.h"
#include        "uart.h"
#include        "adc12.h"
#include        "check.h"
#include        "delay.h"

#include        "eeprom.h"
#include        "LCD12864.h"
#include        "PIX.h"


#endif
