sqf-ice/39_CUITBIKE/(commit log)

2016-08-05 初始化
    初始化
    [CUITBIKE_V1.1_MSP430.brd, CUITBIKE_V1.1_RF.brd, CUITBIKE_V1.1_STM32.brd, CUITBIKE_V1_1.DSN, CUITBIKE_V1_1.opj, F5529_CUITBIKE_V1_1.csv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]
2016-08-05 2016.08.05-14:00
    说明文档修改
2016-11-17 PCB LAYOUT 75%.
    [CUITBIKE_V1.1_MSP430.brd, CUITBIKE_V1_2.DSN, CUITBIKE_V1_2.csv, CUITBIKE_V1_2.opj, STARTUP.OBJ, cases.cfg, chengxu.OBJ, ex100.DSN]
2016-11-22 complete Rev1.2.
    [CUITBIKE_V1.1_MSP430.brd, CUITBIKE_V1.2_MSP430.brd, CUITBIKE_V1_2.DSN, CUITBIKE_V1_2.csv, CUITBIKE_V1_2.opj, CUITBIKE_V1_2_车队码表项目_V1.0.xlsx, art_param.txt, cases.cfg]
2017-06-05 1、update the project.2、add some temp bmp files.
